adafruit/Adafruit-Fruit-Jam-PCB/Adafruit_Fruit_Jam_PrettyPins.pdf

# Adafruit Fruit Jam

# https://www.adafruit.com/product/6200

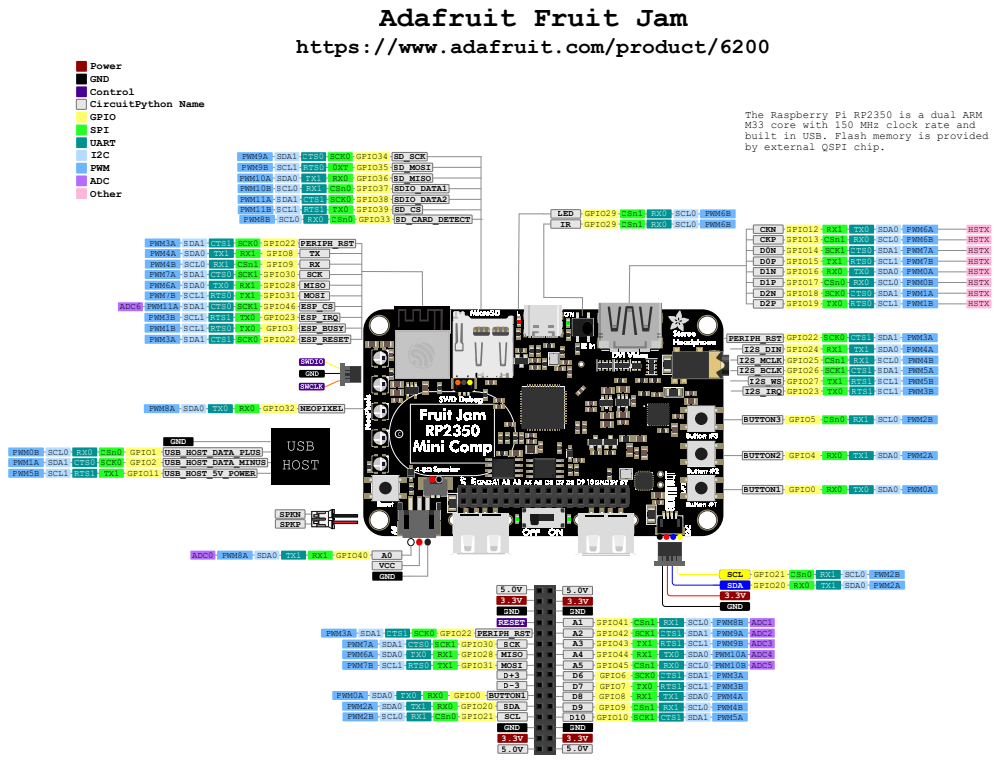
[picture p2: page 1]
PWM3A SDA1 CTS1 SCK0 GPIO22; SCL GPIO21 CSn0 RX1 SCL0 PWM2B SDA GPIO20 RX0 TX1 SDA0 PWM2A 3.3V; SDA; SCL; GND; PWM3B SCL1 RTS1 TX0 GPIO23 ESP_IRQ; ADC6 PWM11A SDA1 CTS0 SCK1 GPIO46 ESP_CS PWM1B SCL1 RTS0 TX0 GPIO3 ESP_BUSY PWM3A SDA1 CTS1 SCK0 GPIO22 ESP_RESET; PWM8A SDA0 TX0 RX0 GPIO32 NEOPIXEL; BUTTON1 GPIO0 RX0 TX0 SDA0 PWM0A; BUTTON2 GPIO4 RX0 TX1 SDA0 PWM2A; BUTTON3 GPIO5 CSn0 RX1 SCL0 PWM2B; CKN GPIO12 RX1 TX0 SDA0 PWM6A; HSTX; CKP GPIO13 CSn1 RX0 SCL0 PWM6B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

The Raspberry Pi RP2350 is a dual ARM
M33 core with 150 MHz clock rate and
built in USB. Flash memory is provided
by external QSPI chip.
