adafruit/Adafruit-Fruit-Jam-PCB/Adafruit Fruit Jam Front Plate.sch

## EAGLE design Adafruit Fruit Jam Front Plate.sch (2025-07-15)

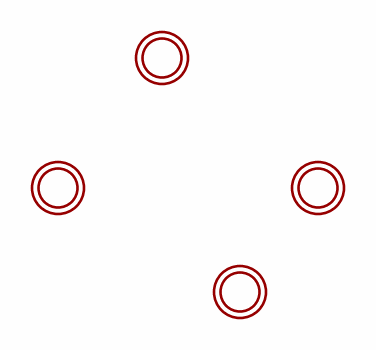
[picture p3: schematic Adafruit Fruit Jam Front Plate.sch]

Parts:
U$1, U$2, U$3, U$4: MOUNTINGHOLE3.0THIN; MOUNTINGHOLE_3.0_PLATEDTHIN
