adafruit/Adafruit-Fruit-Jam-PCB/Adafruit Fruit Jam.sch

## EAGLE design Adafruit Fruit Jam.sch (2025-07-15)

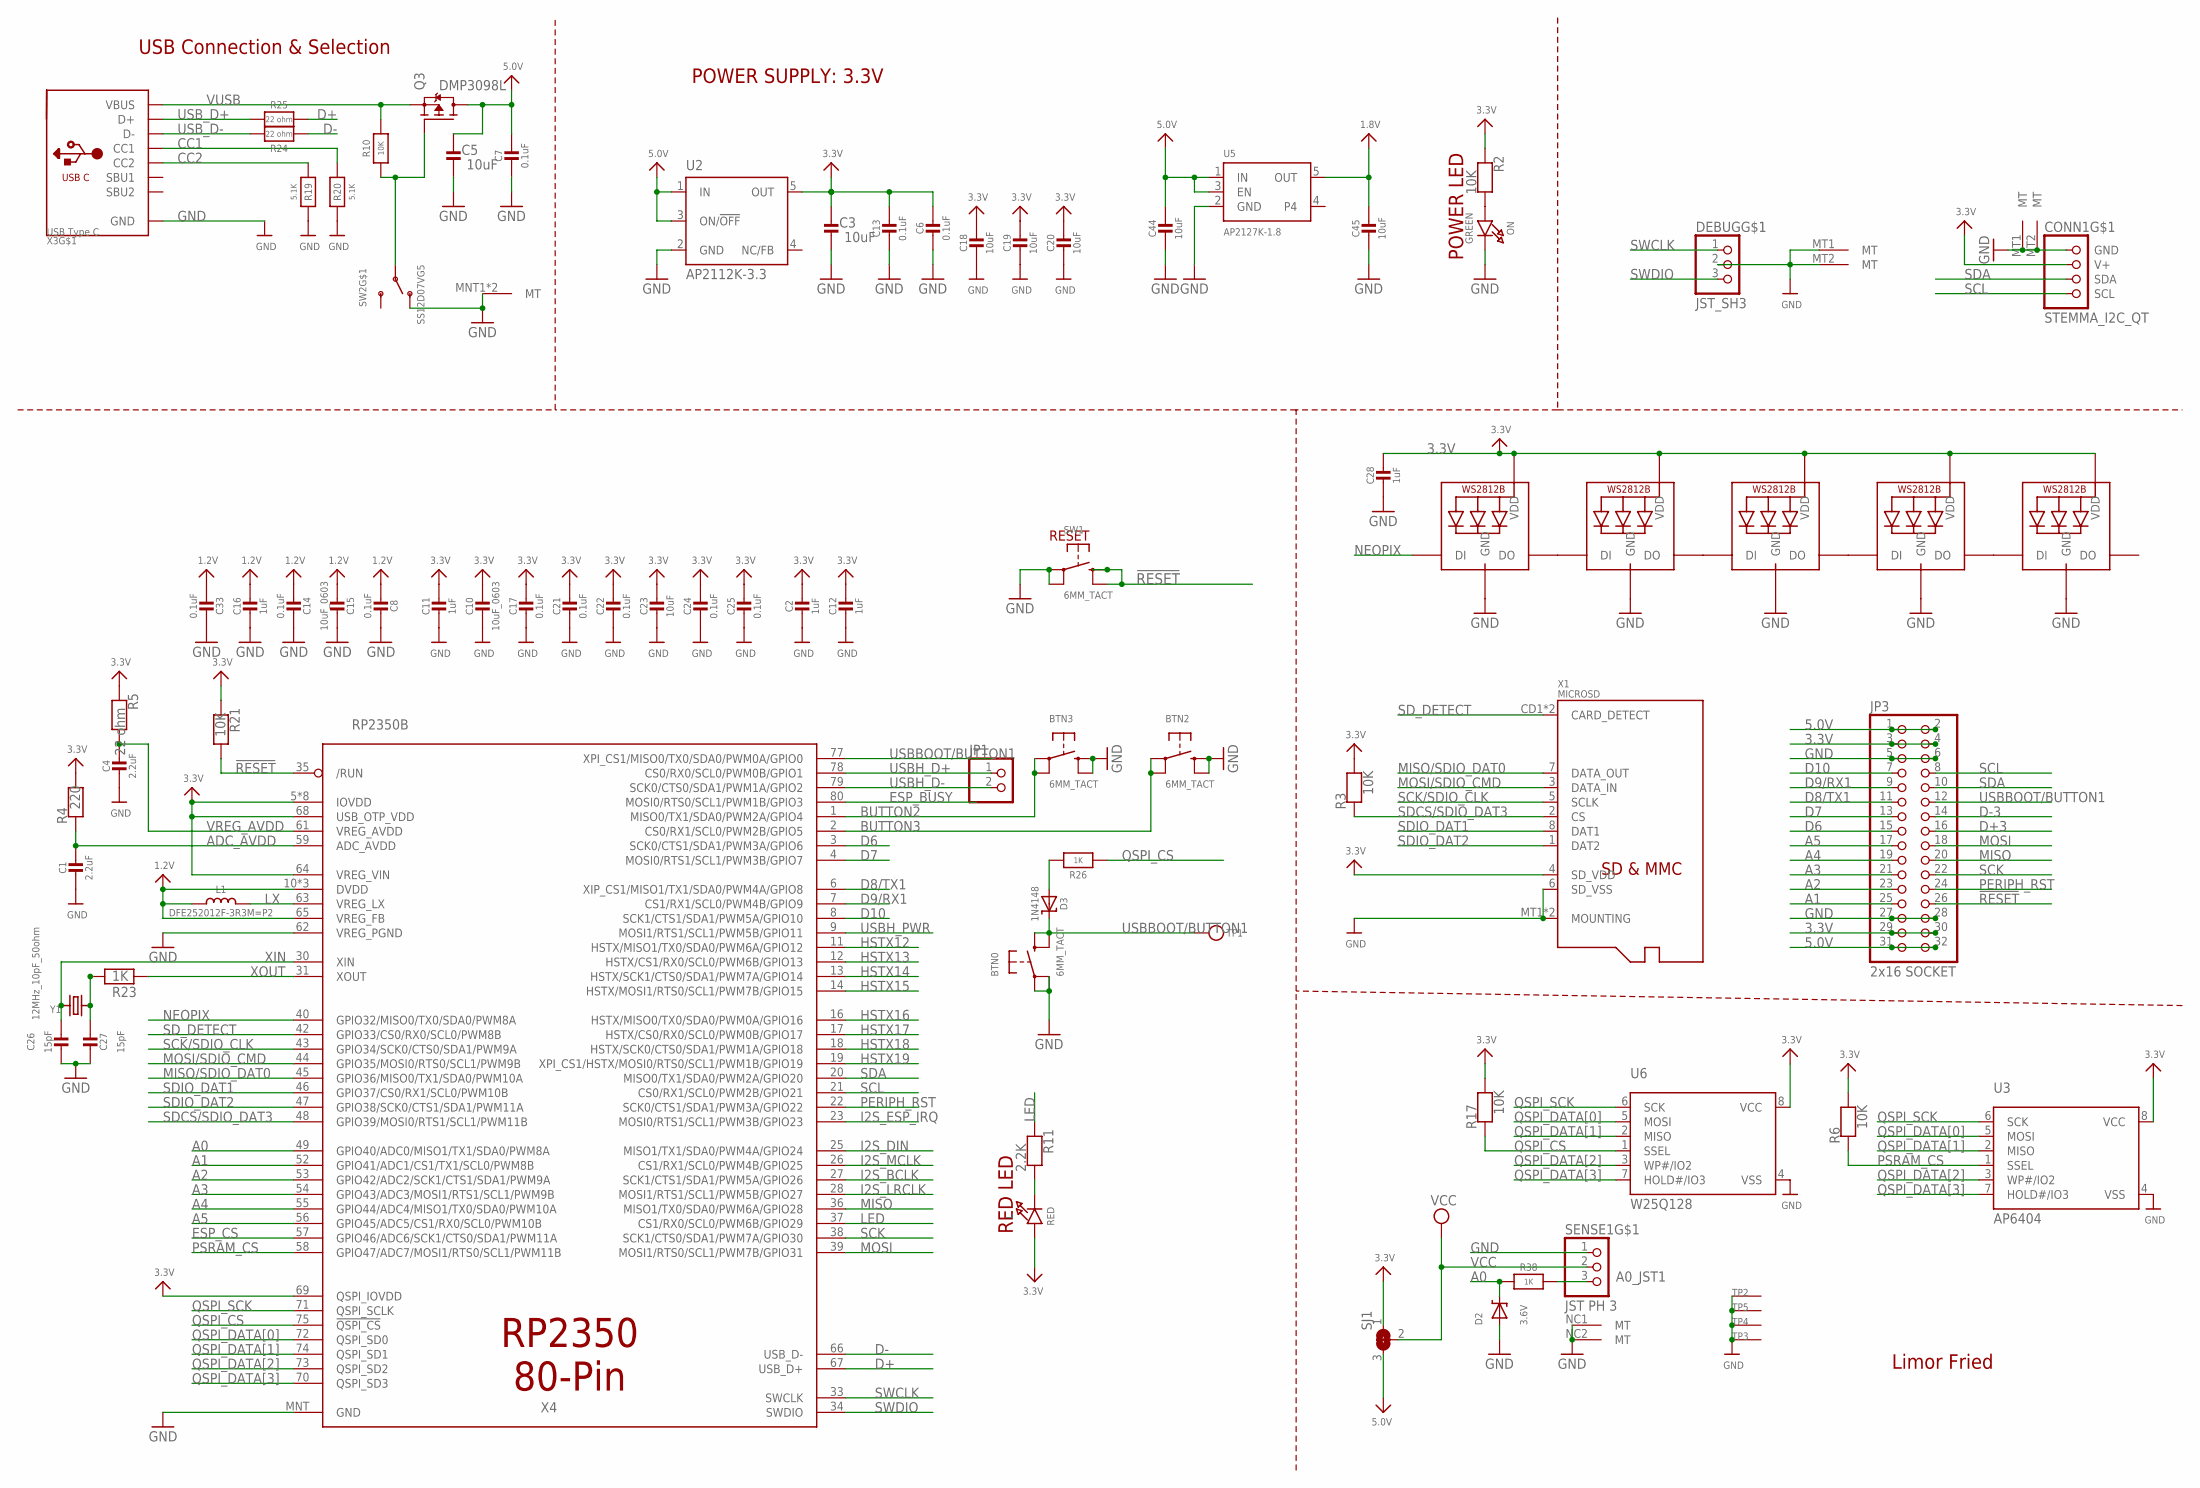
[picture p4: schematic Adafruit Fruit Jam.sch, sheet 1]

Parts:
BTN0, BTN2, BTN3: 6MM_TACT; EVQ-Q2
C1, C4: 2.2uF; 0603-NO
C2, C11, C12, C16, C28: 1uF; 0603-NO
C3, C5, C18, C19, C20, C23, C44, C45: 10uF; 0805-NO
C6, C7, C8, C13, C14, C17, C21, C22, C24, C25, C33: 0.1uF; 0603-NO
C10, C15: 10uF_0603; 0603-NO_WIDE
C26, C27: 15pF; 0603-NO
CONN1: STEMMA_I2C_QT; JST_SH4
D2: 3.6V; SOD-323
D3: 1N4148; SOD-323
DEBUG: JST_SH3; JST_SH3_RA
JP1: HEADER-1X2ROUND; 1X02_ROUND
JP3: 2x16 SOCKET; 2X16
L: RED; CHIPLED_0603_NOOUTLINE
L1: DFE252012F-3R3M=P2; INDUCTOR_1007
LED1, LED2, LED3, LED4, LED5: WS2812B_3535FULL; LED3535_FULLPADS
ON: GREEN; CHIPLED_0603_NOOUTLINE
Q3: DMP3098L; SOT23-WIDE
R2, R3, R6, R10, R17, R21: 10K; 0603-NO
R4: 220; 0603-NO
R5, R24, R25: 22 ohm; 0603-NO
R11: 2.2K; 0603-NO
R19, R20: 5.1K; 0603-NO
R23, R26, R38: 1K; 0603-NO
SENSE1: JST PH 3; JSTPH3
SJ1: SOLDERJUMPER_2WAY; SOLDERJUMPER_2WAY_OPEN_NOPASTE
SW1: 6MM_TACT; EVQ-Q2
SW2: SS12D07VG5; SPDT_SS12D07VG5
TP1: TESTPOINTROUND1.5MMNO; TESTPOINT_ROUND_1.5MM_NO
TP2: DNP; SMT_NUT_3MM
TP3, TP4, TP5: SEWTAP_SMTNUTM3; SMT_NUT_3MM
U2: AP2112K-3.3; SOT23-DBV
U3: AP6404; SOIC8_208MIL
U5: AP2127K-1.8; SOT23-5
U6: W25Q128; SOIC8_208MIL
X1: MICROSD
X3: USB Type C; USB_C_CUSB31-CFM2AX-01-X
X4: RP2350B; QFN80
Y1: 12MHz_10pF_50ohm; CRYSTAL_2.5X2

Connections:
1.2V: C8.2, C14.2, C15.2, C16.1, C33.2, L1.P$1 (1), X4.10 (DVDD), X4.65 (VREG_FB)
1.8V: C45.1, U5.5 (OUT)
3.3V: C2.1, C3.2, C6.2, C10.1, C11.1, C12.1, C13.1, C17.1, C18.1, C19.1, C20.1, C21.1, C22.1, C23.1, C24.1, C25.1, C28.1, CONN1.2 (V+), JP3.3, JP3.4, JP3.29, JP3.30, L.A, LED1.2 (VDD), LED2.2 (VDD), LED3.2 (VDD), LED4.2 (VDD), LED5.2 (VDD), R2.1, R3.2, R4.2, R5.1, R6.2, R17.2, R21.1, SJ1.1, U2.5 (OUT), U3.8 (VCC), U6.8 (VCC), X1.4 (SD_VDD), X4.5 (IOVDD), X4.64 (VREG_VIN), X4.68 (USB_OTP_VDD), X4.69 (QSPI_IOVDD)
5.0V: C5.2, C7.1, C44.1, JP3.1, JP3.2, JP3.31, JP3.32, Q3.3 (D), SJ1.3, U2.1 (IN), U2.3 (ON/!OFF), U5.1 (IN), U5.3 (EN)
!RESET: JP3.26, R21.2, SW1.B (S), SW1.B' (S1), X4.35 (/RUN)
A0: D2.C, R38.2, X4.49 (GPIO40/ADC0/MISO1/TX1/SDA0/PWM8A)
A0_JST1: R38.1, SENSE1.3
A1: JP3.25, X4.52 (GPIO41/ADC1/CS1/TX1/SCL0/PWM8B)
A2: JP3.23, X4.53 (GPIO42/ADC2/SCK1/CTS1/SDA1/PWM9A)
A3: JP3.21, X4.54 (GPIO43/ADC3/MOSI1/RTS1/SCL1/PWM9B)
A4: JP3.19, X4.55 (GPIO44/ADC4/MISO1/TX0/SDA0/PWM10A)
A5: JP3.17, X4.56 (GPIO45/ADC5/CS1/RX0/SCL0/PWM10B)
ADC_AVDD: C1.1, R4.1, X4.59 (ADC_AVDD)
BUTTON2: BTN3.A, BTN3.A' (P1), X4.1 (MISO0/TX1/SDA0/PWM2A/GPIO4)
BUTTON3: BTN2.A, BTN2.A' (P1), X4.2 (CS0/RX1/SCL0/PWM2B/GPIO5)
CC1: R20.2, X3.A5 (CC1)
CC2: R19.2, X3.B5 (CC2)
D6: JP3.15, X4.3 (SCK0/CTS1/SDA1/PWM3A/GPIO6)
D7: JP3.13, X4.4 (MOSI0/RTS1/SCL1/PWM3B/GPIO7)
D8/TX1: JP3.11, X4.6 (XIP_CS1/MISO1/TX1/SDA0/PWM4A/GPIO8)
D9/RX1: JP3.9, X4.7 (CS1/RX1/SCL0/PWM4B/GPIO9)
D10: JP3.7, X4.8 (SCK1/CTS1/SDA1/PWM5A/GPIO10)
D+: R25.2, X4.67 (USB_D+)
D+3: JP3.16
D-: R24.2, X4.66 (USB_D-)
D-3: JP3.14
ESP_BUSY: X4.80 (MOSI0/RTS0/SCL1/PWM1B/GPIO3)
ESP_CS: X4.57 (GPIO46/ADC6/SCK1/CTS0/SDA1/PWM11A)
GND: BTN0.A, BTN0.A' (P1), BTN2.B (S), BTN2.B' (S1), BTN3.B (S), BTN3.B' (S1), C1.2, C2.2, C3.1, C4.2, C5.1, C6.1, C7.2, C8.1, C10.2, C11.2, C12.2, C13.2, C14.1, C15.1, C16.2, C17.2, C18.2, C19.2, C20.2, C21.2, C22.2, C23.2, C24.2, C25.2, C26.1, C27.1, C28.2, C33.1, C44.2, C45.2, CONN1.1 (GND), CONN1.MT1 (MT), CONN1.MT2 (MT), D2.A, DEBUG.2, DEBUG.MT1 (MT), DEBUG.MT2 (MT), JP3.5, JP3.6, JP3.27, JP3.28, LED1.4 (GND), LED2.4 (GND), LED3.4 (GND), LED4.4 (GND), LED5.4 (GND), ON.C, R19.1, R20.1, SENSE1.1, SENSE1.NC1 (MT), SENSE1.NC2 (MT), SW1.A, SW1.A' (P1), SW2.MNT1 (MT), SW2.T1 (O), TP2.P$1, TP3.P$1, TP4.P$1, TP5.P$1, U2.2 (GND), U3.4 (VSS), U5.2 (GND), U6.4 (VSS), X1.6 (SD_VSS), X1.MT1 (MOUNTING), X3.A1B12 (GND), X4.62 (VREG_PGND), X4.MNT (GND)
HSTX12: X4.11 (HSTX/MISO1/TX0/SDA0/PWM6A/GPIO12)
HSTX13: X4.12 (HSTX/CS1/RX0/SCL0/PWM6B/GPIO13)
HSTX14: X4.13 (HSTX/SCK1/CTS0/SDA1/PWM7A/GPIO14)
HSTX15: X4.14 (HSTX/MOSI1/RTS0/SCL1/PWM7B/GPIO15)
HSTX16: X4.16 (HSTX/MISO0/TX0/SDA0/PWM0A/GPIO16)
HSTX17: X4.17 (HSTX/CS0/RX0/SCL0/PWM0B/GPIO17)
HSTX18: X4.18 (HSTX/SCK0/CTS0/SDA1/PWM1A/GPIO18)
HSTX19: X4.19 (XPI_CS1/HSTX/MOSI0/RTS0/SCL1/PWM1B/GPIO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)
I2S_BCLK: X4.27 (SCK1/CTS1/SDA1/PWM5A/GPIO26)
I2S_DIN: X4.25 (MISO1/TX1/SDA0/PWM4A/GPIO24)
I2S_ESP_IRQ: X4.23 (MOSI0/RTS1/SCL1/PWM3B/GPIO23)
I2S_LRCLK: X4.28 (MOSI1/RTS1/SCL1/PWM5B/GPIO27)
I2S_MCLK: X4.26 (CS1/RX1/SCL0/PWM4B/GPIO25)
LED: R11.1, X4.37 (CS1/RX0/SCL0/PWM6B/GPIO29)
LX: L1.P$2 (2), X4.63 (VREG_LX)
MISO: JP3.20, X4.36 (MISO1/TX0/SDA0/PWM6A/GPIO28)
MISO/SDIO_DAT0: X1.7 (DATA_OUT), X4.45 (GPIO36/MISO0/TX1/SDA0/PWM10A)
MOSI: JP3.18, X4.39 (MOSI1/RTS0/SCL1/PWM7B/GPIO31)
MOSI/SDIO_CMD: X1.3 (DATA_IN), X4.44 (GPIO35/MOSI0/RTS0/SCL1/PWM9B)
unnamed: L.C, R11.2
unnamed: ON.A, R2.2
unnamed: LED1.1 (DI), LED2.3 (DO)
unnamed: D3.A, R26.2
unnamed: LED1.3 (DO), LED3.1 (DI)
unnamed: C27.2, R23.1, Y1.3 (2)
unnamed: LED3.3 (DO), LED4.1 (DI)
unnamed: LED4.3 (DO), LED5.1 (DI)
NEOPIX: LED2.1 (DI), X4.40 (GPIO32/MISO0/TX0/SDA0/PWM8A)
PERIPH_RST: JP3.24, X4.22 (SCK0/CTS1/SDA1/PWM3A/GPIO22)
PSRAM_CS: R6.1, U3.1 (SSEL), X4.58 (GPIO47/ADC7/MOSI1/RTS0/SCL1/PWM11B)
PWR_SWITCH: Q3.1 (G), R10.1, SW2.P
QSPI_CS: R17.1, R26.1, U6.1 (SSEL), X4.75 (!QSPI_CS)
QSPI_DATA[0]: U3.5 (MOSI), U6.5 (MOSI), X4.72 (QSPI_SD0)
QSPI_DATA[1]: U3.2 (MISO), U6.2 (MISO), X4.74 (QSPI_SD1)
QSPI_DATA[2]: U3.3 (WP#/IO2), U6.3 (WP#/IO2), X4.73 (QSPI_SD2)
QSPI_DATA[3]: U3.7 (HOLD#/IO3), U6.7 (HOLD#/IO3), X4.70 (QSPI_SD3)
QSPI_SCK: U3.6 (SCK), U6.6 (SCK), X4.71 (QSPI_SCLK)
SCK: JP3.22, X4.38 (SCK1/CTS0/SDA1/PWM7A/GPIO30)
SCK/SDIO_CLK: X1.5 (SCLK), X4.43 (GPIO34/SCK0/CTS0/SDA1/PWM9A)
SCL: CONN1.4 (SCL), JP3.8, X4.21 (CS0/RX1/SCL0/PWM2B/GPIO21)
SDA: CONN1.3 (SDA), JP3.10, X4.20 (MISO0/TX1/SDA0/PWM2A/GPIO20)
SDCS/SDIO_DAT3: R3.1, X1.2 (CS), X4.48 (GPIO39/MOSI0/RTS1/SCL1/PWM11B)
SDIO_DAT1: X1.8 (DAT1), X4.46 (GPIO37/CS0/RX1/SCL0/PWM10B)
SDIO_DAT2: X1.1 (DAT2), X4.47 (GPIO38/SCK0/CTS1/SDA1/PWM11A)
SD_DETECT: X1.CD1 (CARD_DETECT), X4.42 (GPIO33/CS0/RX0/SCL0/PWM8B)
SWCLK: DEBUG.1, X4.33 (SWCLK)
SWDIO: DEBUG.3, X4.34 (SWDIO)
USBBOOT/BUTTON1: BTN0.B (S), BTN0.B' (S1), D3.C, JP3.12, TP1.P$1, X4.77 (XPI_CS1/MISO0/TX0/SDA0/PWM0A/GPIO0)
USBH_D+: JP1.1, X4.78 (CS0/RX0/SCL0/PWM0B/GPIO1)
USBH_D-: JP1.2, X4.79 (SCK0/CTS0/SDA1/PWM1A/GPIO2)
USBH_PWR: X4.9 (MOSI1/RTS1/SCL1/PWM5B/GPIO11)
USB_D+: R25.1, X3.A6 (D+)
USB_D-: R24.1, X3.A7 (D-)
VCC: SENSE1.2, SJ1.2
VREG_AVDD: C4.1, R5.2, X4.61 (VREG_AVDD)
VUSB: Q3.2 (S), R10.2, X3.A4B9 (VBUS)
XIN: C26.2, X4.30 (XIN), Y1.1
XOUT: R23.2, X4.31 (XOUT)

Notes on the sheet:
Limor Fried
USB Connection & Selection
POWER SUPPLY: 3.3V
POWER LED
RED LED
RESET

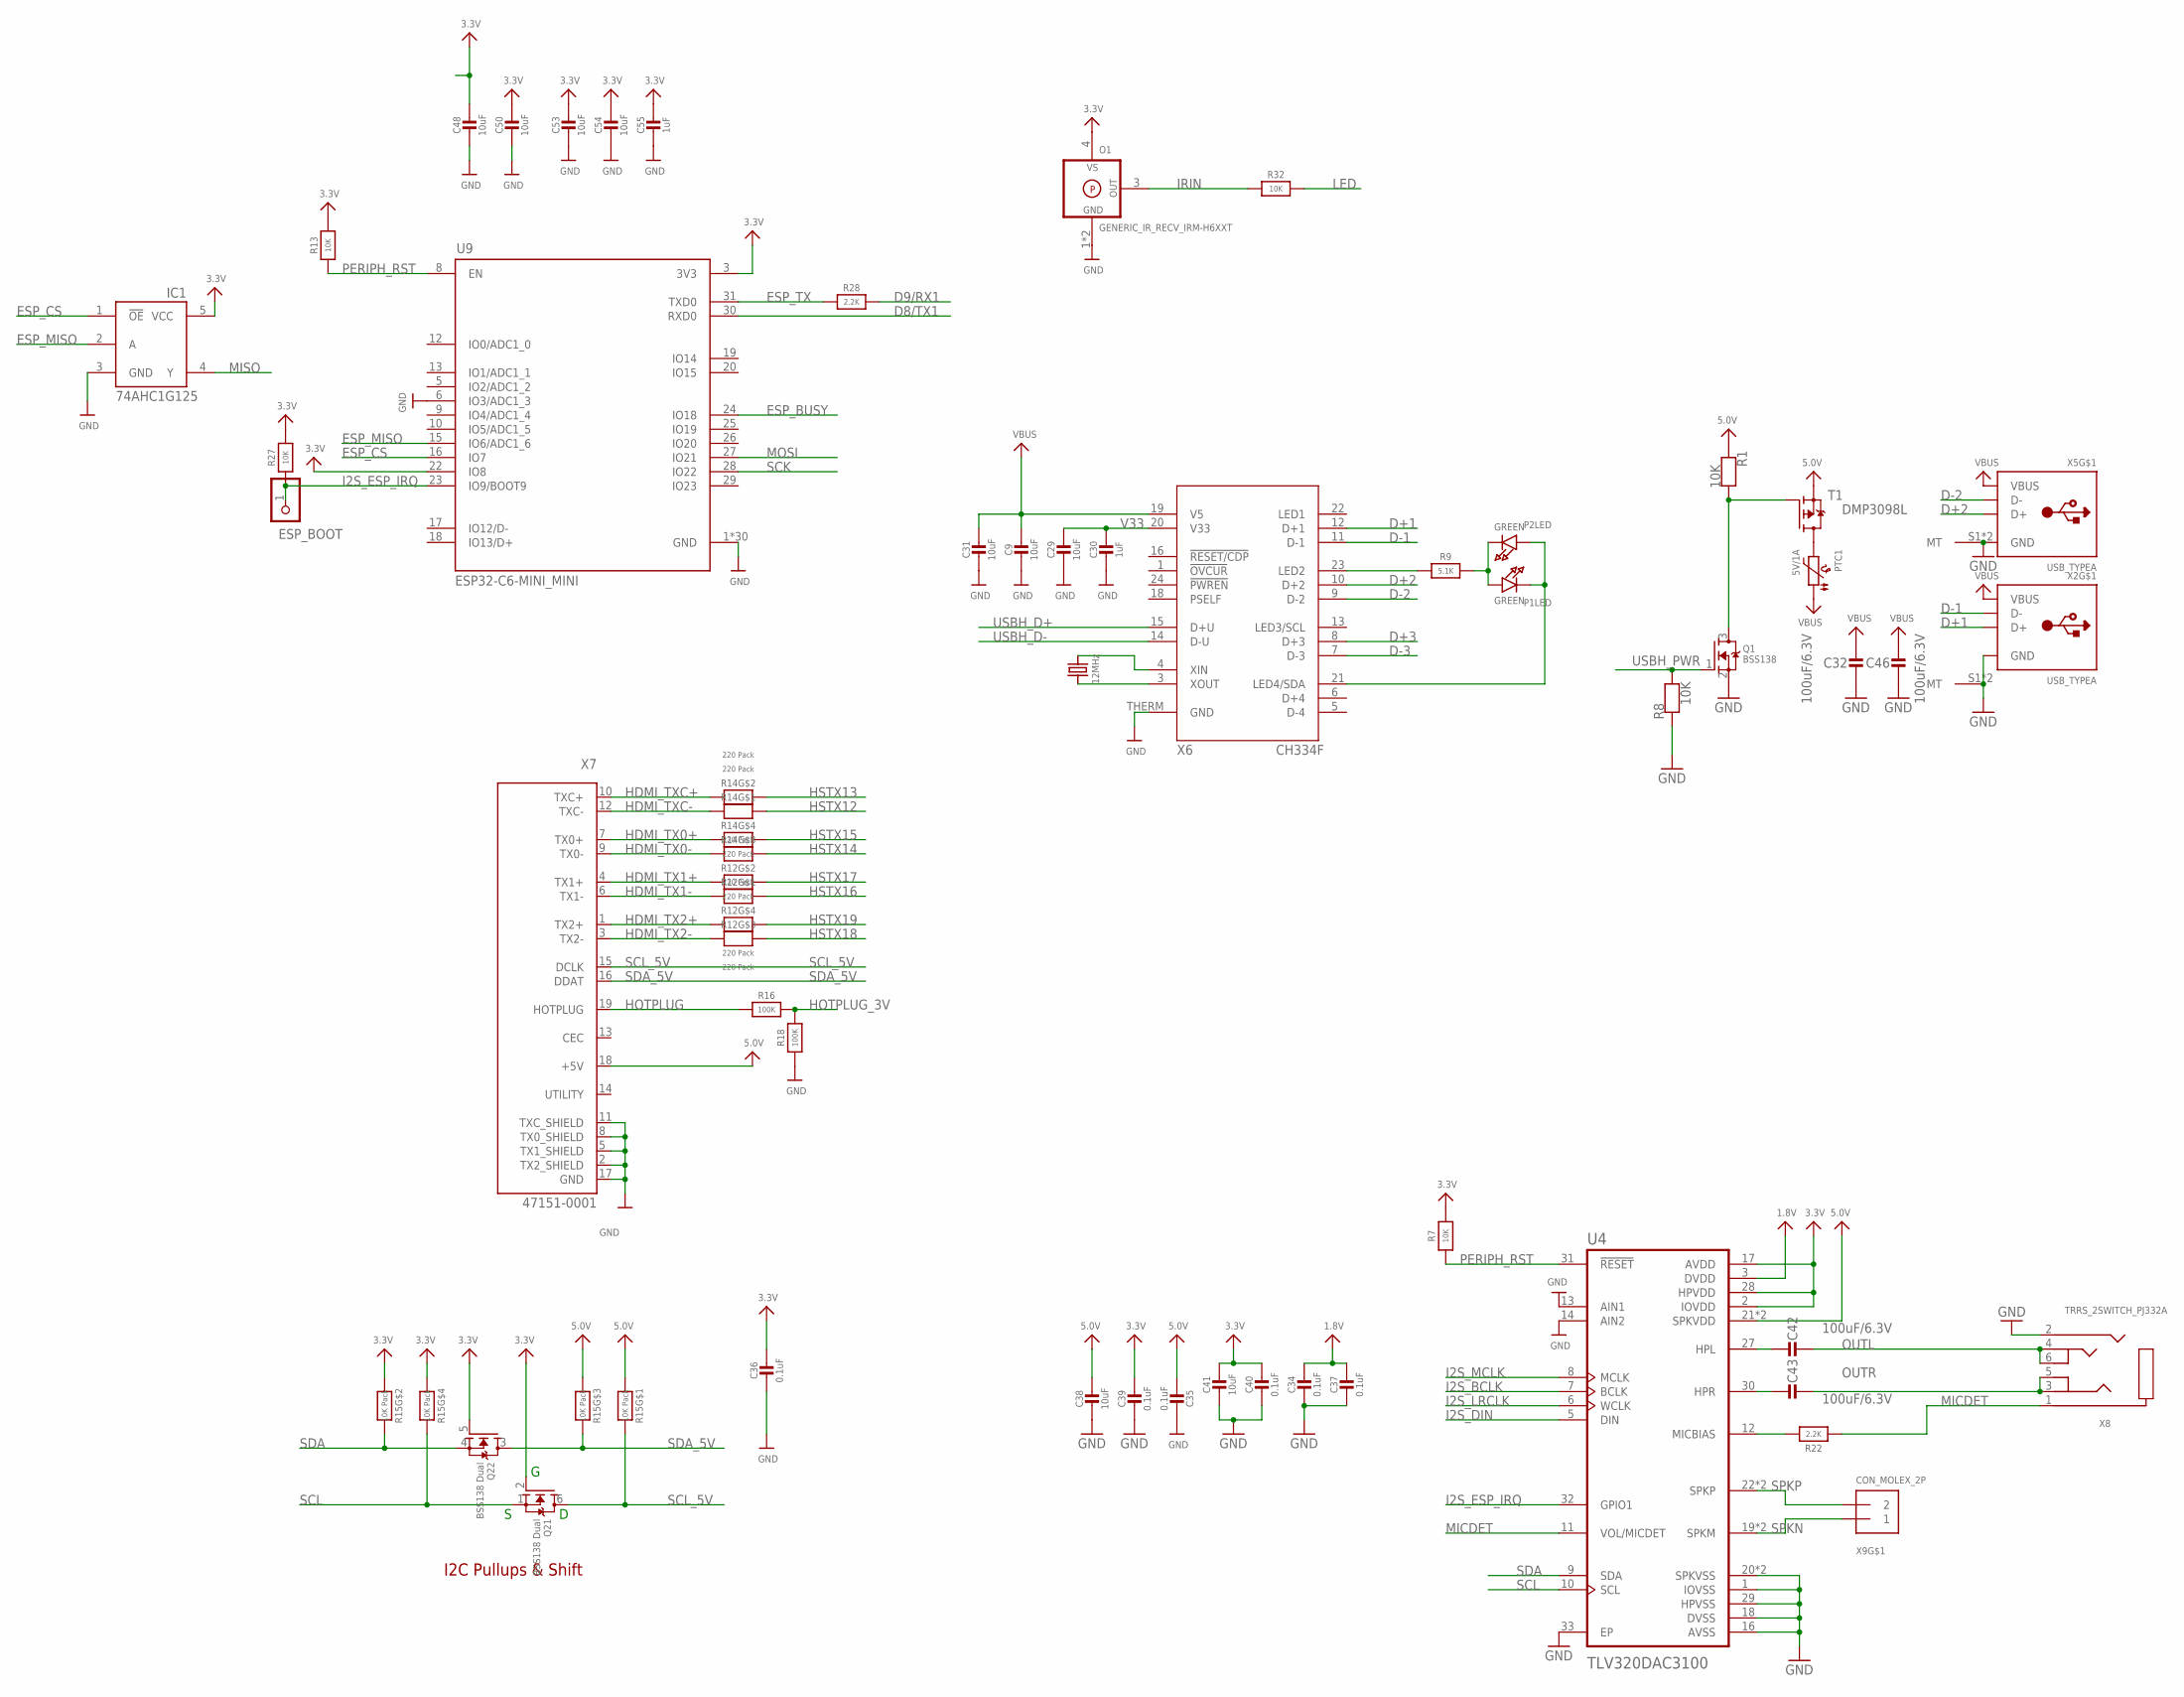
[picture p5: schematic Adafruit Fruit Jam.sch, sheet 2]

Parts:
C9, C29, C31, C38, C41, C48, C50, C53, C54: 10uF; 0805-NO
C30, C55: 1uF; 0603-NO
C32, C42, C43, C46: 100uF/6.3V; _1206
C34, C35, C36, C37, C39, C40: 0.1uF; 0603-NO
ESP_BOOT: HEADER-1X1ROUND; 1X01_ROUND
IC1: 74AHC1G125; SOT23-5L
O1: GENERIC_IR_RECV_IRM-H6XXT; IRM-H6XXT
P1LED, P2LED: GREEN; CHIPLED_0603_NOOUTLINE
PTC1: 5V/1A; 0805-NO
Q1: BSS138; SOT23-WIDE
Q2: BSS138 Dual; SOT363
R1, R7, R8, R13, R27, R32: 10K; 0603-NO
R9: 5.1K; 0603-NO
R12, R14: 220 Pack; RESPACK_4X0603
R15: 10K Pack; RESPACK_4X0603
R16, R18: 100K; 0603-NO
R22, R28: 2.2K; 0603-NO
T1: DMP3098L; SOT23-WIDE
U4: TLV320DAC3100
U9: ESP32-C6-MINI_MINI; ESP32-PICO-MINI
X2, X5: USB_TYPEA; USB_TYPE_A_THM_SHORT
X6: CH334F; QFN24_4MM
X7: 47151-0001; HDMI_MOLEX_47151-0001
X8: TRRS_2SWITCH_PJ332A; PJ-332A
X9: CON_MOLEX_2P; 53398-0271
Y2: 12MHz; CRYSTAL_2.5X2

Connections:
1.8V: C34.1, C37.1, U4.3 (DVDD)
3.3V: C36.1, C39.1, C40.1, C41.1, C48.1, C50.1, C53.1, C54.1, C55.1, IC1.5 (VCC), O1.4 (VS), Q2.2 (G), Q2.5 (G), R7.2, R13.2, R15.5 (2), R15.7 (2), R27.2, U4.2 (IOVDD), U4.17 (AVDD), U4.28 (HPVDD), U9.3 (3V3), U9.22 (IO8)
5.0V: C35.2, C38.1, R1.1, R15.6 (2), R15.8 (2), T1.2 (S), U4.21 (SPKVDD), X7.18 (+5V)
D8/TX1: U9.30 (RXD0)
D9/RX1: R28.1
D+1: X2.D+, X6.12 (D+1)
D+2: X5.D+, X6.10 (D+2)
D+3: X6.8 (D+3)
D-1: X2.D-, X6.11 (D-1)
D-2: X5.D-, X6.9 (D-2)
D-3: X6.7 (D-3)
ESP_BUSY: U9.24 (IO18)
ESP_CS: IC1.1 (!OE), U9.16 (IO7)
ESP_MISO: IC1.2 (A), U9.15 (IO6/ADC1_6)
ESP_TX: R28.2, U9.31 (TXD0)
GND: C9.2, C29.2, C30.2, C31.2, C32.1, C34.2, C35.1, C36.2, C37.2, C38.2, C39.2, C40.2, C41.2, C46.1, C48.2, C50.2, C53.2, C54.2, C55.2, IC1.3 (GND), O1.1 (GND), Q1.2 (S), R8.1, R18.1, U4.1 (IOVSS), U4.13 (AIN1), U4.14 (AIN2), U4.16 (AVSS), U4.18 (DVSS), U4.20 (SPKVSS), U4.29 (HPVSS), U4.33 (EP), U9.1 (GND), U9.6 (IO3/ADC1_3), X2.GND, X2.S1 (MT), X5.GND, X5.S1 (MT), X6.THERM (GND), X7.2 (TX2_SHIELD), X7.5 (TX1_SHIELD), X7.8 (TX0_SHIELD), X7.11 (TXC_SHIELD), X7.17 (GND), X8.2 (RING1)
HDMI_TX0+: R14.4 (1), X7.7 (TX0+)
HDMI_TX0-: R14.3 (1), X7.9 (TX0-)
HDMI_TX1+: R12.2 (1), X7.4 (TX1+)
HDMI_TX1-: R12.1, X7.6 (TX1-)
HDMI_TX2+: R12.4 (1), X7.1 (TX2+)
HDMI_TX2-: R12.3 (1), X7.3 (TX2-)
HDMI_TXC+: R14.2 (1), X7.10 (TXC+)
HDMI_TXC-: R14.1, X7.12 (TXC-)
HOTPLUG: R16.1, X7.19 (HOTPLUG)
HOTPLUG_3V: R16.2, R18.2
HSTX12: R14.8 (2)
HSTX13: R14.7 (2)
HSTX14: R14.6 (2)
HSTX15: R14.5 (2)
HSTX16: R12.8 (2)
HSTX17: R12.7 (2)
HSTX18: R12.6 (2)
HSTX19: R12.5 (2)
I2S_BCLK: U4.7 (BCLK)
I2S_DIN: U4.5 (DIN)
I2S_ESP_IRQ: ESP_BOOT.1, R27.1, U4.32 (GPIO1), U9.23 (IO9/BOOT9)
I2S_LRCLK: U4.6 (WCLK)
I2S_MCLK: U4.8 (MCLK)
IRIN: O1.3 (OUT), R32.2
LED: R32.1
MICDET: R22.1, U4.11 (VOL/MICDET), X8.1 (RING)
MISO: IC1.4 (Y)
MOSI: U9.27 (IO21)
unnamed: PTC1.2, T1.3 (D)
unnamed: Q1.3 (D), R1.2, T1.1 (G)
unnamed: X6.3 (XOUT), Y2.1
unnamed: X6.4 (XIN), Y2.3 (2)
unnamed: P1LED.A, P2LED.C, R9.2
unnamed: R9.1, X6.23 (LED2)
unnamed: P1LED.C, P2LED.A, X6.21 (LED4/SDA)
unnamed: C43.1, U4.30 (HPR)
unnamed: C42.1, U4.27 (HPL)
unnamed: R22.2, U4.12 (MICBIAS)
OUTL: C42.2, X8.4 (TIP), X8.6 (TIP_SW)
OUTR: C43.2, X8.3 (RING2), X8.5 (R2_SW)
PERIPH_RST: R7.1, R13.1, U4.31 (!RESET), U9.8 (EN)
SCK: U9.28 (IO22)
SCL: Q2.1 (S), R15.4 (1), U4.10 (SCL)
SCL_5V: Q2.6 (D), R15.1, X7.15 (DCLK)
SDA: Q2.4 (S), R15.2 (1), U4.9 (SDA)
SDA_5V: Q2.3 (D), R15.3 (1), X7.16 (DDAT)
SPKN: U4.19 (SPKM), X9.1
SPKP: U4.22 (SPKP), X9.2
USBH_D+: X6.15 (D+U)
USBH_D-: X6.14 (D-U)
USBH_PWR: Q1.1 (G), R8.2
V33: C29.1, C30.1, X6.20 (V33)
VBUS: C9.1, C31.1, C32.2, C46.2, PTC1.1, X2.VBUS, X5.VBUS, X6.19 (V5)

Notes on the sheet:
I2C Pullups & Shift
